GLuisF/KiCad/3D Models/6941xx301002.step

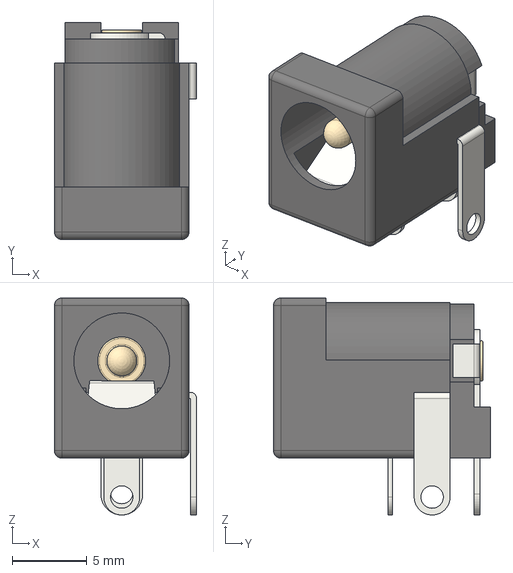
[picture p1: CAD file, 2022-11-30]
3D Models/6941xx301002.step
9.50 x 14.5 x 14.5 mm
