GLuisF/KiCad/3dmodels/TS02_66_70_BK_100_LCR.step

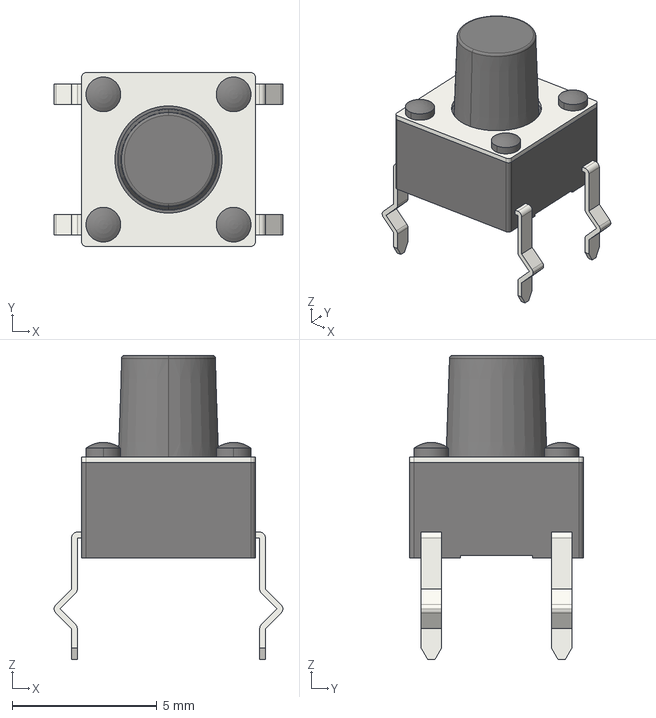
[picture p2: CAD file, 2025-11-11]
3dmodels/TS02_66_70_BK_100_LCR.step
7.90 x 6.00 x 10.5 mm
