GLuisF/KiCad/3dmodels/SS12F23.step

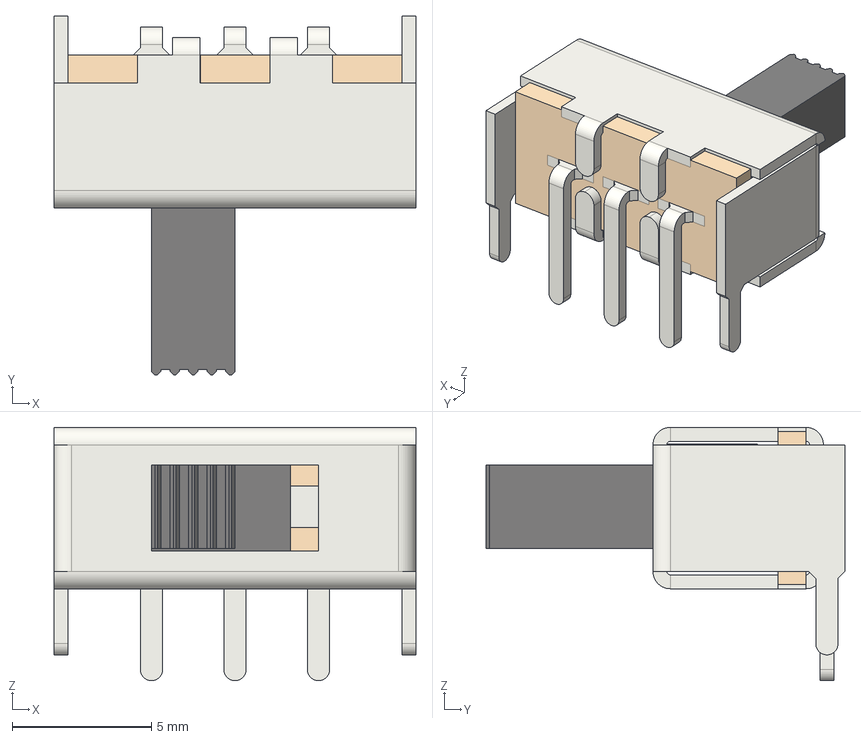
[picture p3: CAD file, 2025-09-01]
3dmodels/SS12F23.step
13.0 x 12.9 x 9.10 mm
