GLuisF/KiCad/3dmodels/SW_E-Switch_SS12F23_SPDT_Angled.step

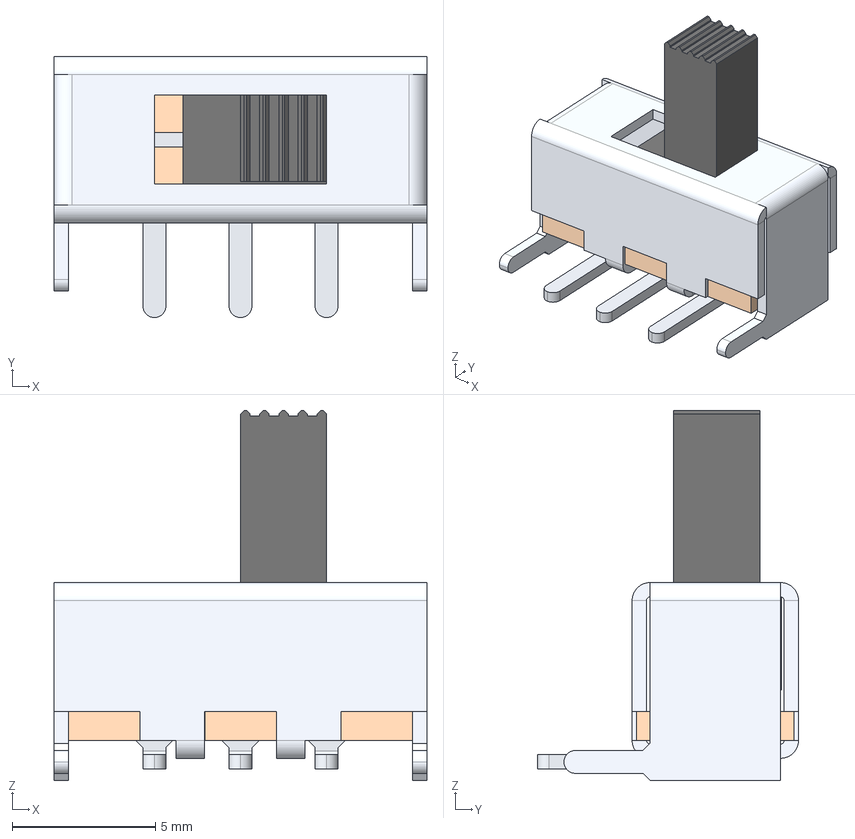
[picture p4: CAD file, 2025-09-01]
3dmodels/SW_E-Switch_SS12F23_SPDT_Angled.step
13.0 x 9.10 x 12.9 mm
SLIDE SWITCH SS12F23 CAPA_Valor predeterminado
SLIDE SWITCH SS12F23 PCB_Valor predeterminado
SLIDE SWITCH SS12F23 CENTRAL_Valor predeterminado
SLIDE SWITCH SS12F23 LATERAL_Valor predeterminado
SLIDE SWITCH SS12F23 LATERAL_Valor predeterminado001
SLIDE SWITCH SS12F23 ATUADOR_Valor predeterminado
SLIDE SWITCH SS12F23 Contato_Valor predeterminado
