GLuisF/KiCad/3dmodels/SW_Slide_SS12F23_SPDT_Angled.FCStd

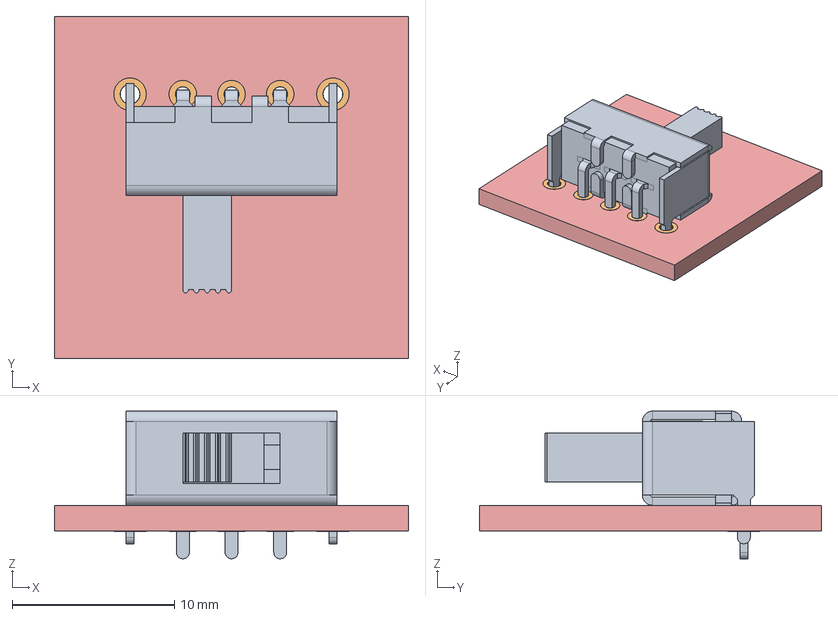
[picture p5: CAD file, 2025-09-01]
3dmodels/SW_Slide_SS12F23_SPDT_Angled.FCStd
21.8 x 21.1 x 9.10 mm
SS12F23
topPads
btmPads
TH-Drills
PCB
