GLuisF/KiCad/3dmodels/HW-106.step

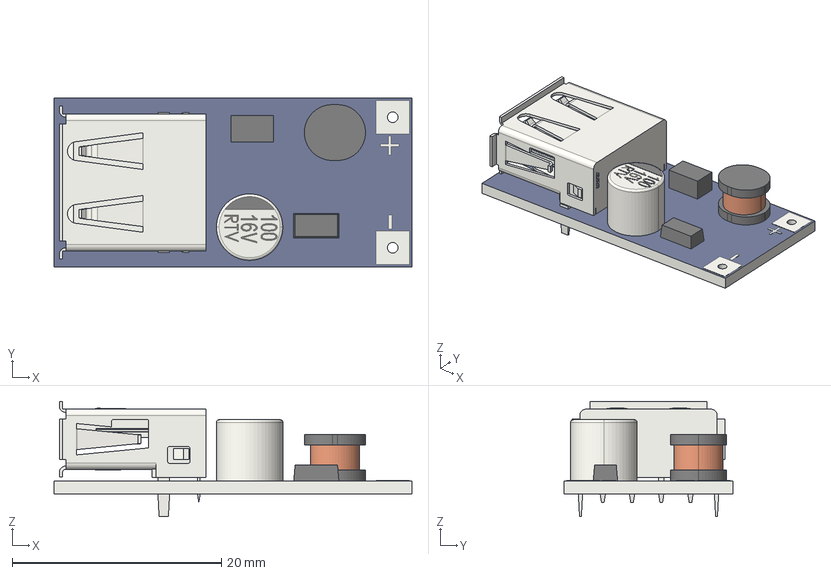
[picture p6: CAD file, 2025-08-31]
3dmodels/HW-106.step
34.2 x 16.2 x 11.0 mm
