GLuisF/KiCad/3dmodels/5621AH.step

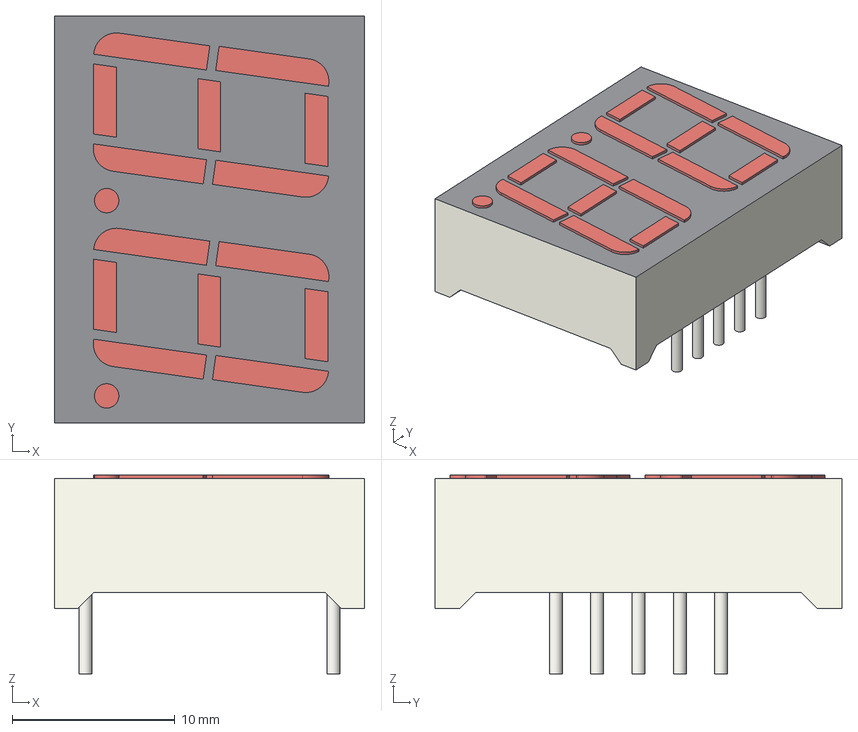
[picture p7: CAD file, 2025-08-25]
3dmodels/5621AH.step
19.1 x 25.0 x 12.2 mm
