GLuisF/KiCad/3dmodels/MQ-131-L.step

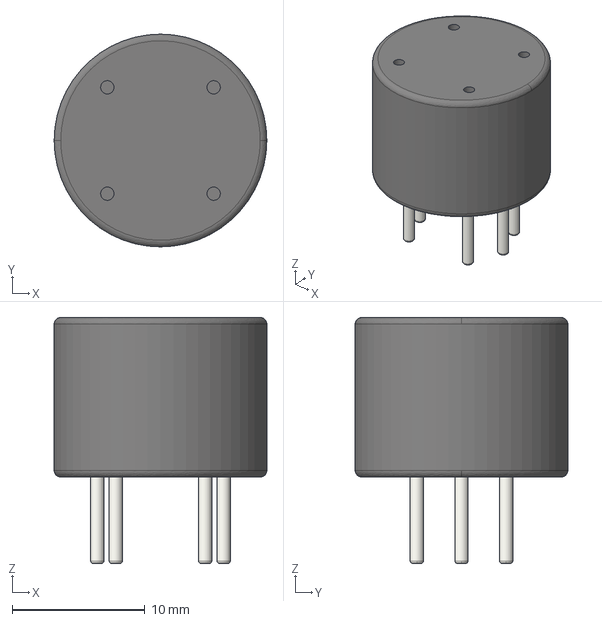
[picture p8: CAD file, 2025-06-23]
3dmodels/MQ-131-L.step
16.0 x 16.0 x 18.5 mm
