GLuisF/KiCad/3dmodels/FSM8JRT.step

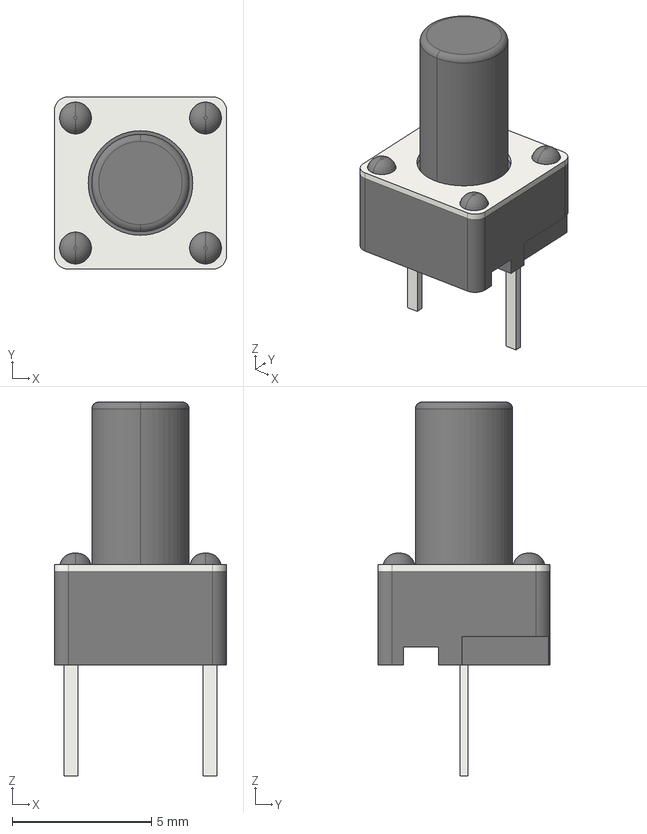
[picture p9: CAD file, 2025-05-14]
3dmodels/FSM8JRT.step
6.20 x 6.20 x 13.4 mm
