GLuisF/KiCad/3dmodels/TO-220-3_Vertical.step

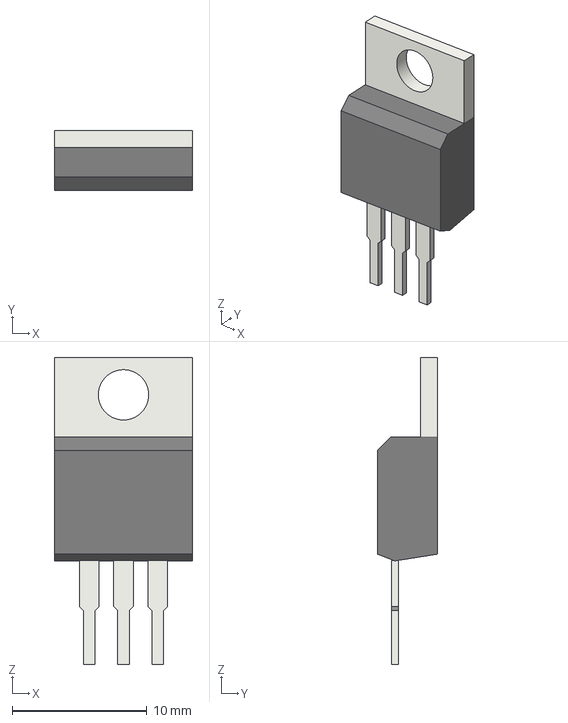
[picture p10: CAD file, 2025-05-14]
3dmodels/TO-220-3_Vertical.step
10.2 x 4.46 x 22.8 mm
