GLuisF/KiCad/3dmodels/3857 Adafruit Feather M4 Express.step

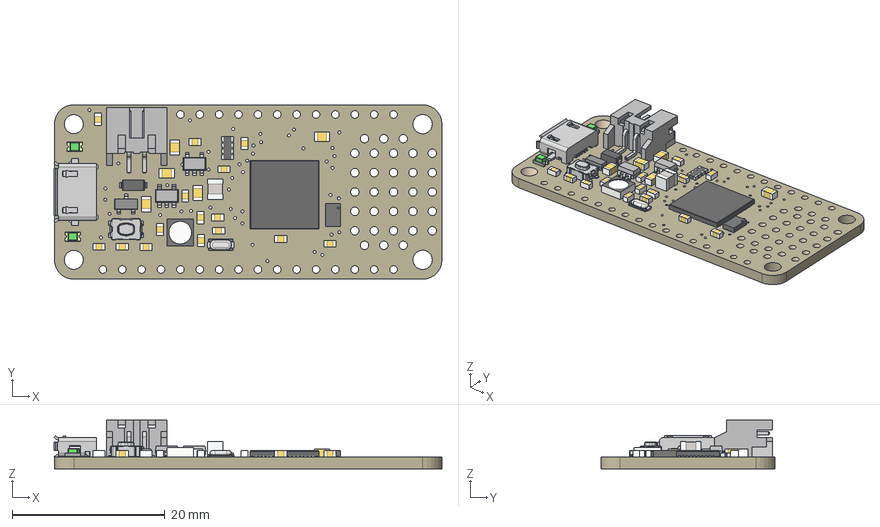
[picture p11: CAD file, 2025-02-12]
3dmodels/3857 Adafruit Feather M4 Express.step
50.9 x 22.9 x 6.37 mm
Board
10uF x 5
1uF x 15
ORANGE x 2
KMR2
microUSB
MCP73831T-2ACI/OT x 2
JSTPH
WS2812B3535
2MB Flash
MBR120
DMG341
100K
ATSAMD51J
10uH
