GLuisF/KiCad/3dmodels/PLCC2835_BLUE.stp

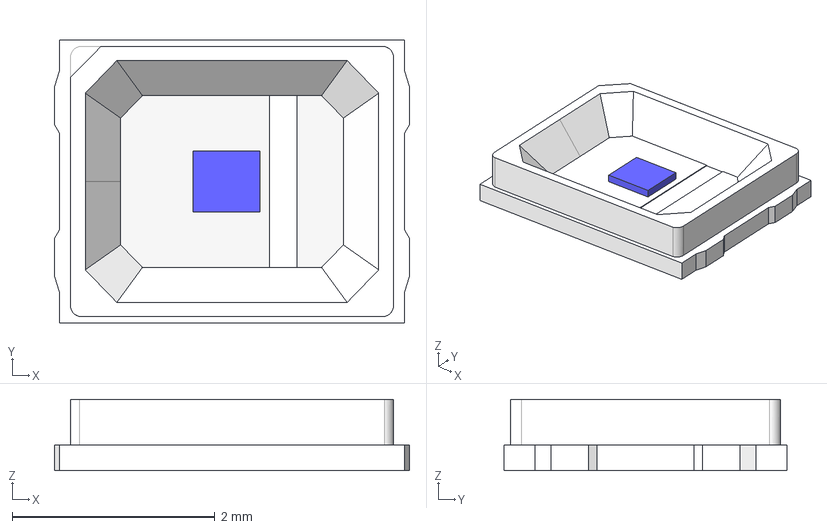
[picture p12: CAD file, 2025-02-12]
3dmodels/PLCC2835_BLUE.stp
3.50 x 2.79 x 0.7 mm
Document
