GLuisF/KiCad/3dmodels/SW_PUSH_E-Switch_FS57003P_3PDT.step

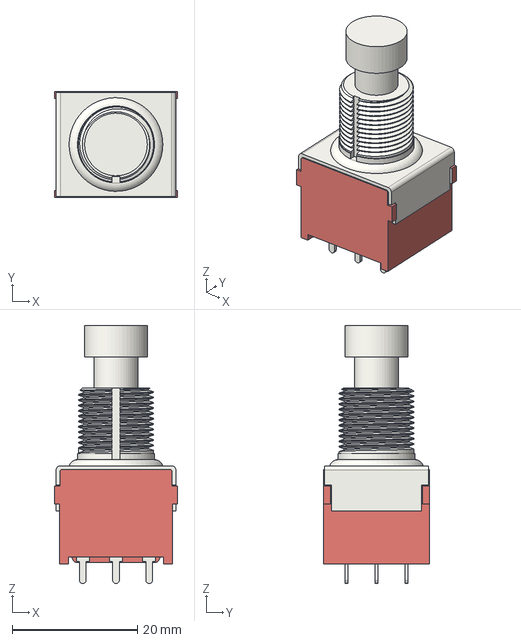
[picture p13: CAD file, 2024-08-29]
3dmodels/SW_PUSH_E-Switch_FS57003P_3PDT.step
19.7 x 17.0 x 41.2 mm
