GLuisF/KiCad/3dmodels/Jack_6.35mm_Amphenol_ACJS-MH_Horizontal.step

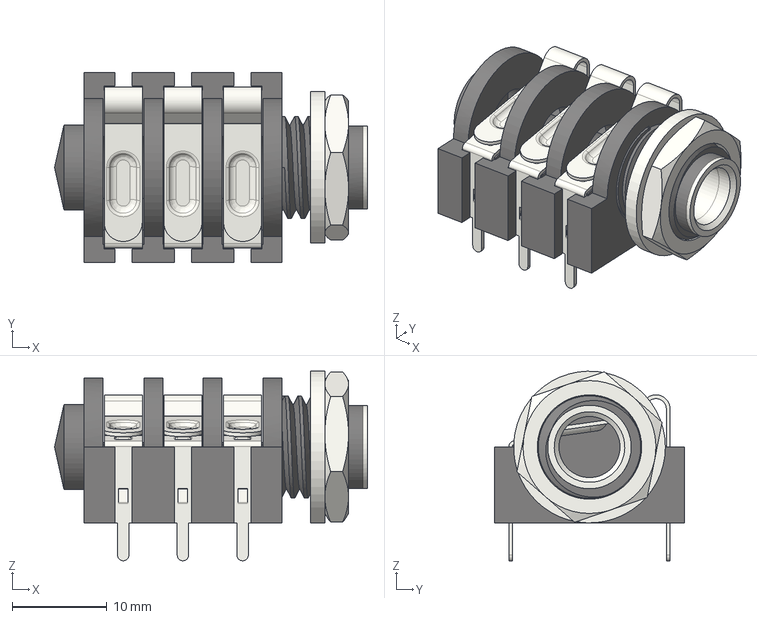
[picture p14: CAD file, 2024-08-29]
3dmodels/Jack_6.35mm_Amphenol_ACJS-MH_Horizontal.step
33.0 x 20.0 x 20.0 mm
