GLuisF/KiCad/3dmodels/CP_Radial_D5.0mm_H11.0mm_P2.00mm.step

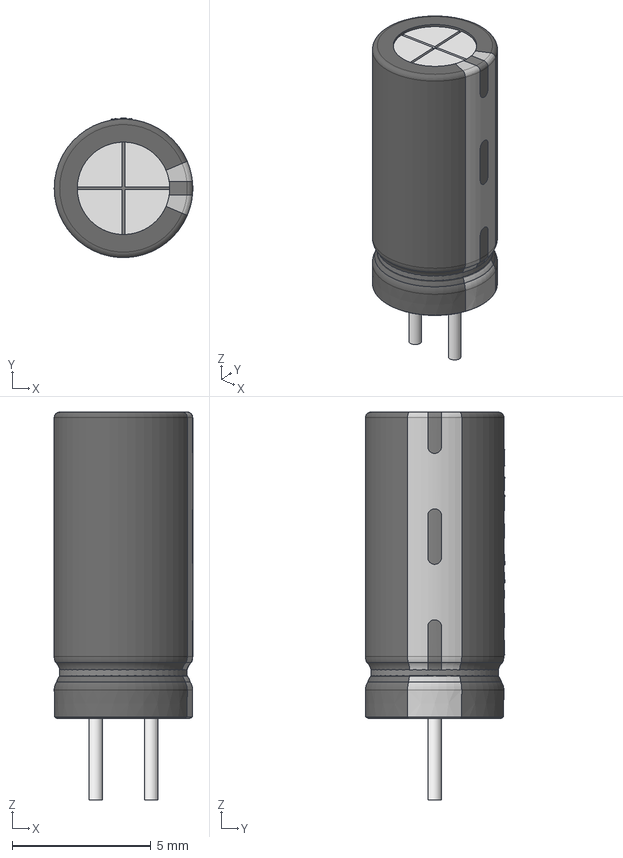
[picture p15: CAD file, 2024-07-31]
3dmodels/CP_Radial_D5.0mm_H11.0mm_P2.00mm.step
5.00 x 5.02 x 14.0 mm
