GLuisF/KiCad/3dmodels/COM-10597.step

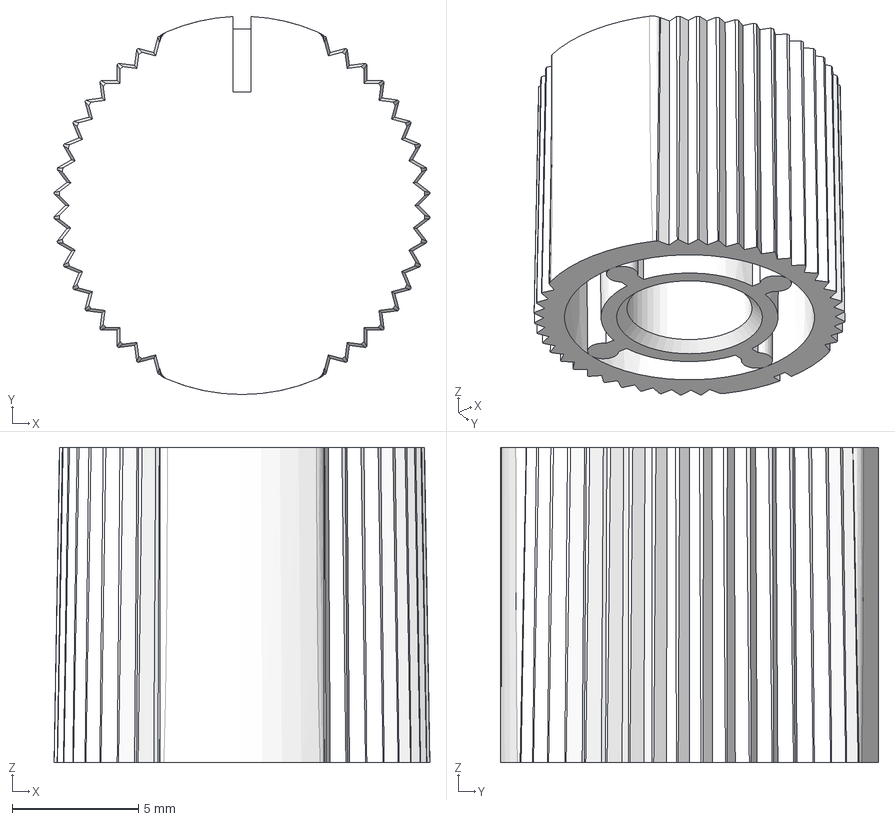
[picture p16: CAD file, 2024-07-03]
3dmodels/COM-10597.step
14.9 x 15.0 x 12.5 mm
