GLuisF/KiCad/3dmodels/TerminalBlock_bornier-2_P5.08mm.step

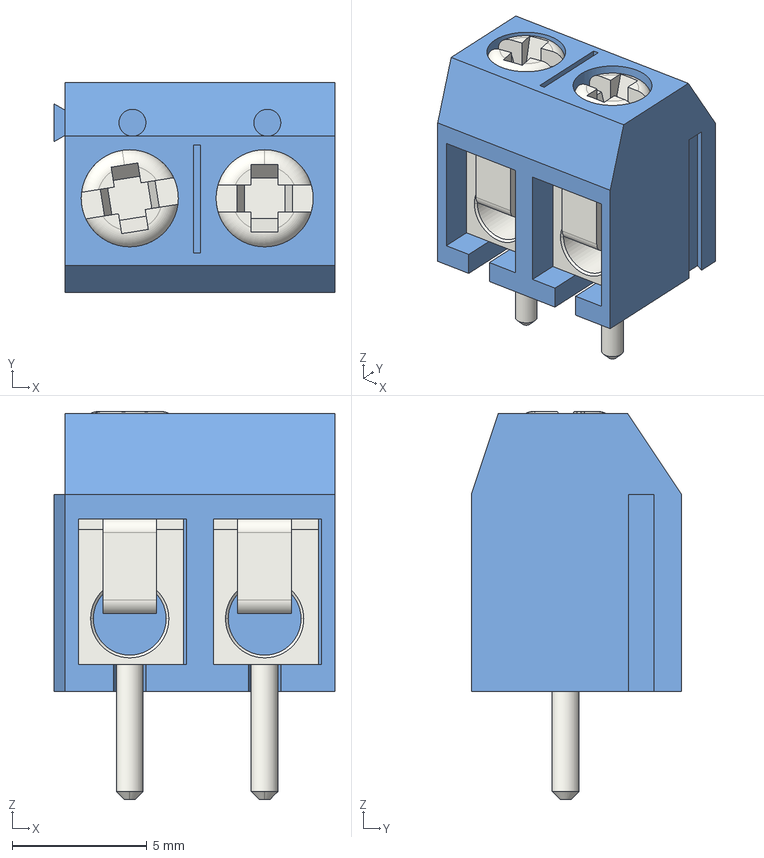
[picture p17: CAD file, 2023-12-06]
3dmodels/TerminalBlock_bornier-2_P5.08mm.step
10.4 x 7.80 x 14.4 mm
