GLuisF/KiCad/3dmodels/3386F.step

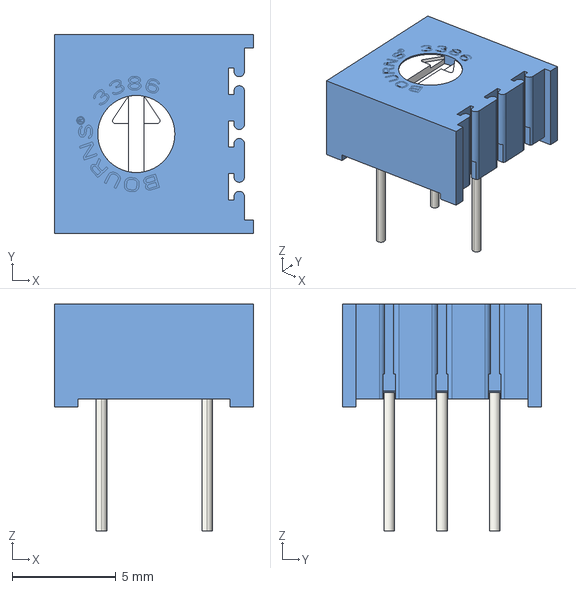
[picture p18: CAD file, 2023-12-06]
3dmodels/3386F.step
9.58 x 9.58 x 10.9 mm
