GLuisF/KiCad/3dmodels/TO-247-3_Horizontal_TabUp.step

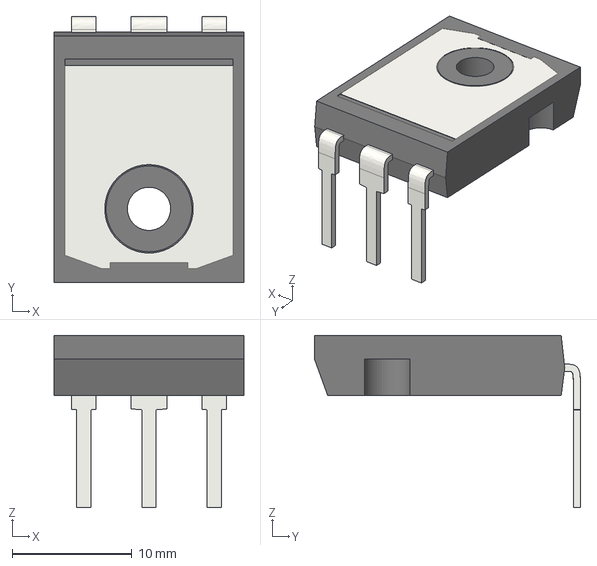
[picture p19: CAD file, 2023-12-06]
3dmodels/TO-247-3_Horizontal_TabUp.step
15.9 x 22.3 x 14.4 mm
