GLuisF/KiCad/3dmodels/TerminalBlock_bornier-3_P5.08mm.step

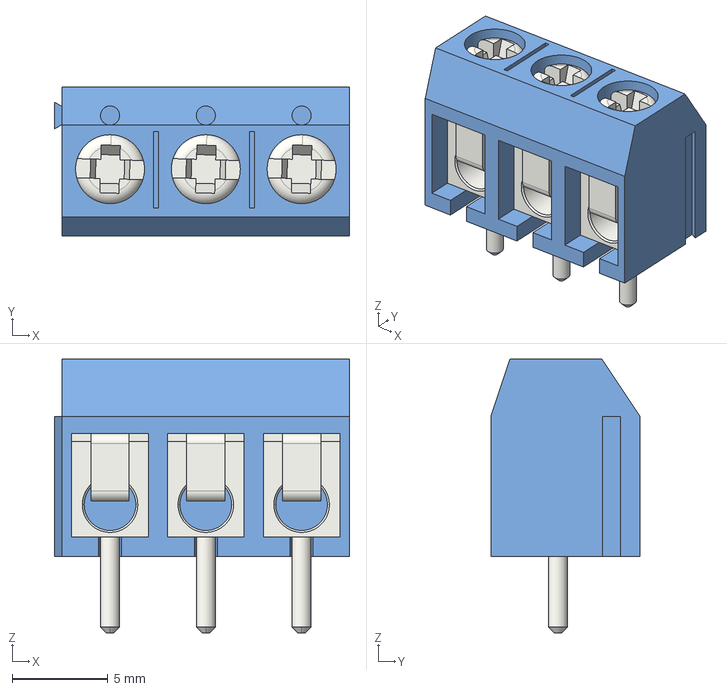
[picture p20: CAD file, 2023-12-06]
3dmodels/TerminalBlock_bornier-3_P5.08mm.step
15.4 x 7.80 x 14.3 mm
