GLuisF/KiCad/3dmodels/Potentiometer_Bourns_3386F_Vertical.step

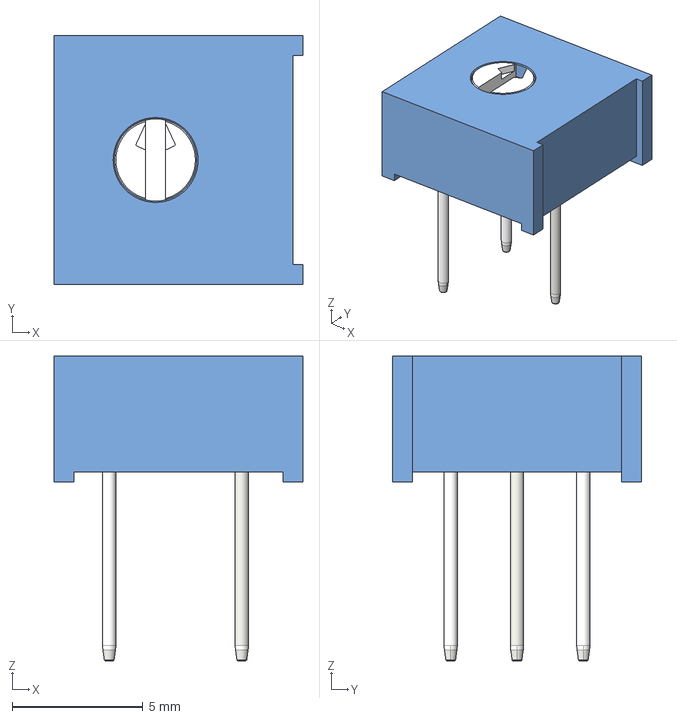
[picture p21: CAD file, 2023-12-06]
3dmodels/Potentiometer_Bourns_3386F_Vertical.step
9.52 x 9.53 x 11.7 mm
