GLuisF/KiCad/3dmodels/RJ12_Amphenol_54601-x06_Horizontal.step

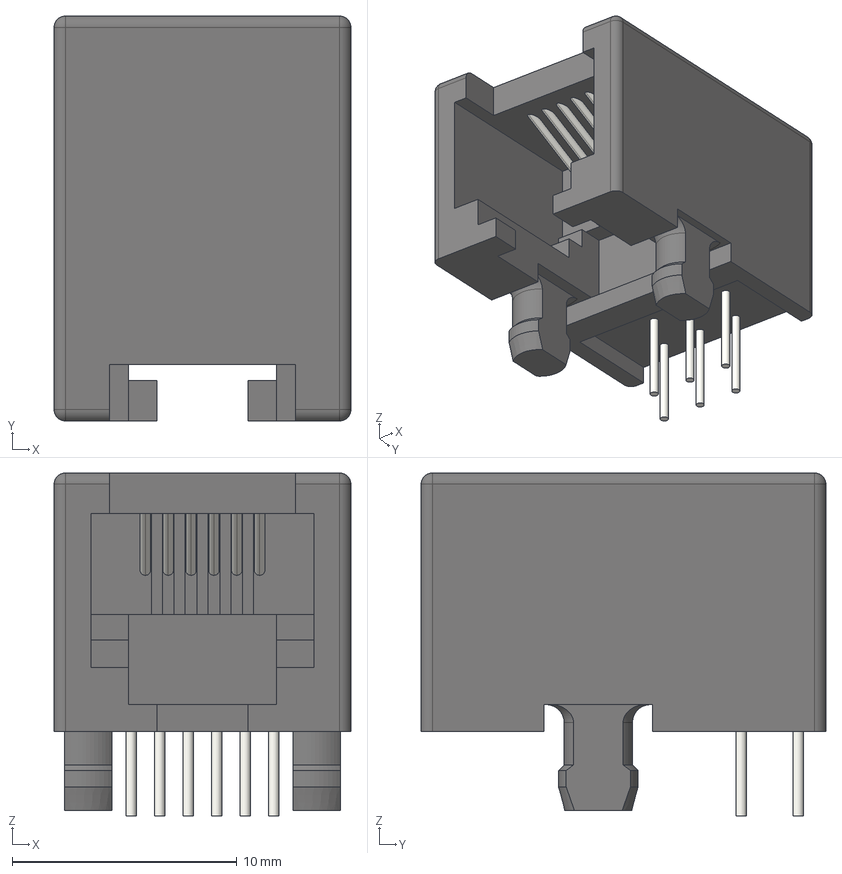
[picture p22: CAD file, 2023-10-30]
3dmodels/RJ12_Amphenol_54601-x06_Horizontal.step
13.2 x 18.0 x 15.2 mm
