GLuisF/KiCad/3dmodels/PEC12R-4222F-S0024.step

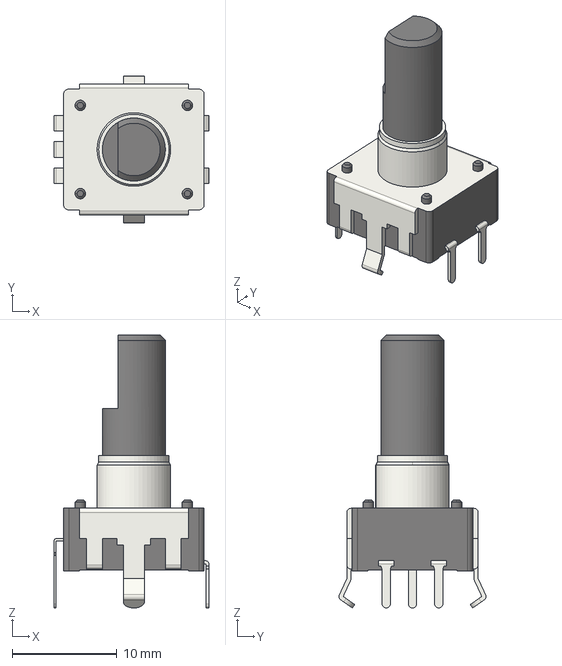
[picture p23: CAD file, 2023-07-28]
3dmodels/PEC12R-4222F-S0024.step
14.7 x 14.0 x 26.0 mm
