GLuisF/KiCad/3dmodels/SOIC-14_to_DIP-14_Adapter.step

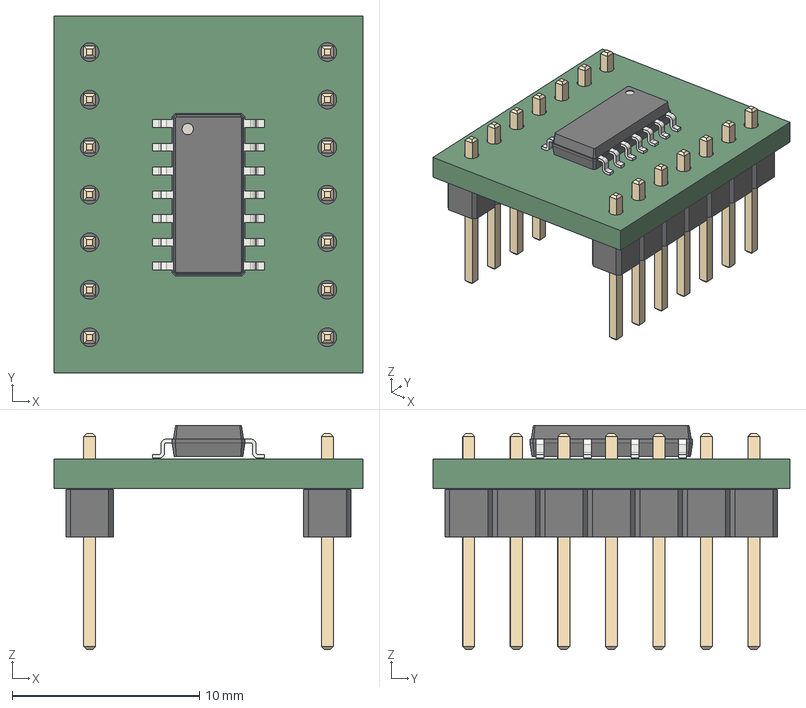
[picture p24: CAD file, 2023-06-08]
3dmodels/SOIC-14_to_DIP-14_Adapter.step
16.5 x 19.1 x 12.0 mm
