GLuisF/KiCad/3dmodels/Interruptor Liga_Desliga.STEP

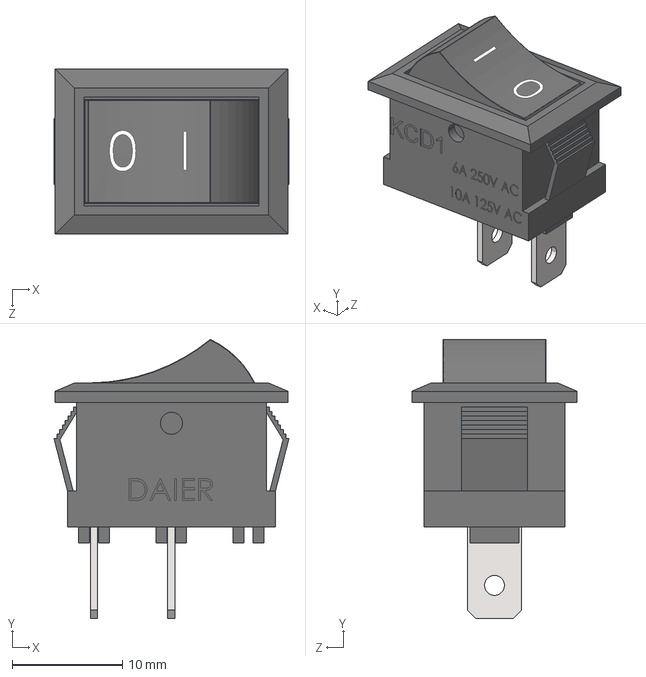
[picture p25: CAD file, 2022-12-01]
3dmodels/Interruptor Liga_Desliga.STEP
21.3 x 25.3 x 15.0 mm
