GLuisF/KiCad/3dmodels/PEL12T-4225S-S1024.step

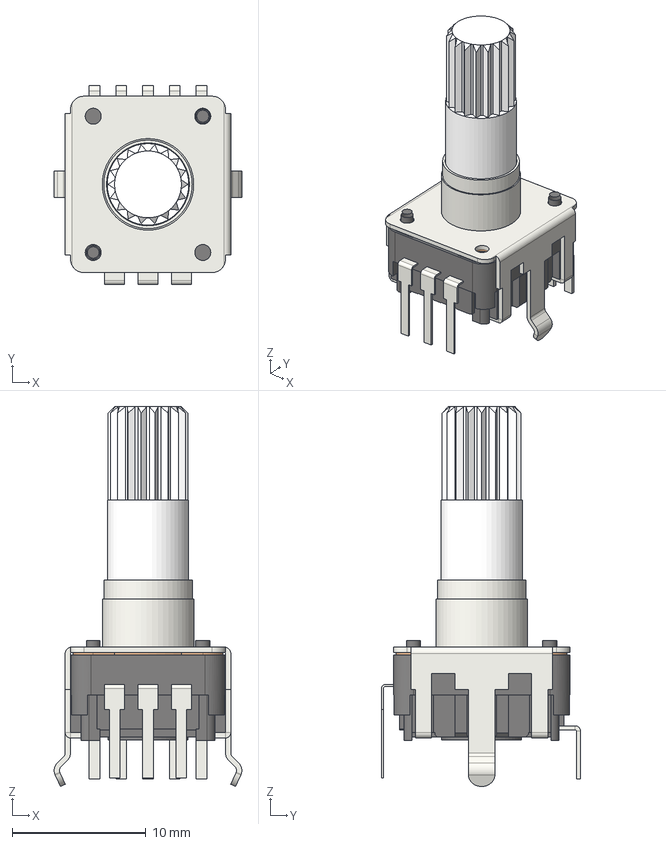
[picture p26: CAD file, 2022-12-01]
3dmodels/PEL12T-4225S-S1024.step
14.1 x 14.9 x 28.4 mm
