GLuisF/KiCad/3dmodels/panel_on-off_spdt.step

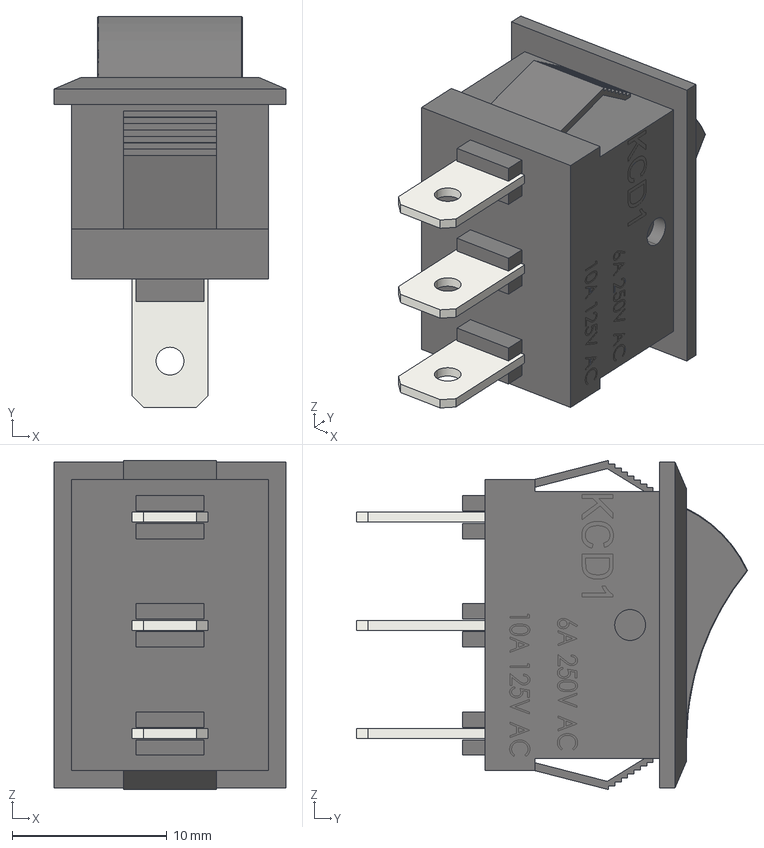
[picture p27: CAD file, 2022-12-01]
3dmodels/panel_on-off_spdt.step
15.0 x 25.3 x 21.3 mm
