GLuisF/KiCad/3dmodels/WE-TPC_3816.step

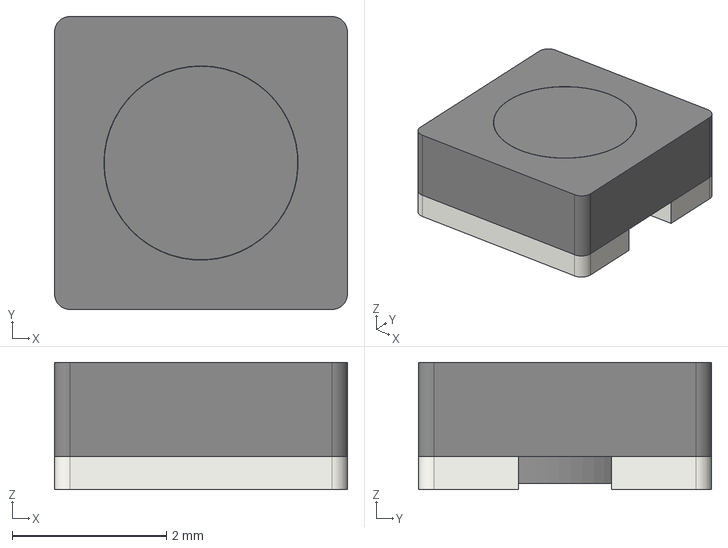
[picture p28: CAD file, 2022-11-30]
3dmodels/WE-TPC_3816.step
3.80 x 3.80 x 1.65 mm
