GLuisF/KiCad/3dmodels/WE-TPC_5828.stp

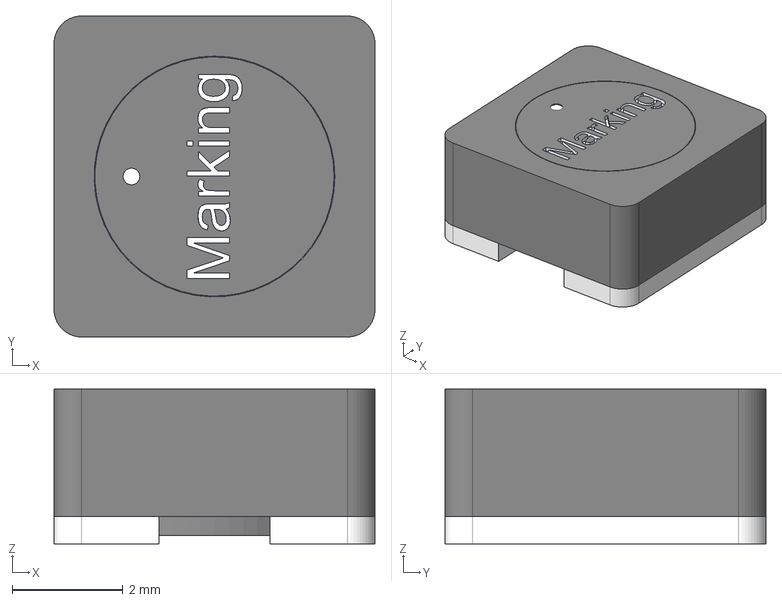
[picture p29: CAD file, 2022-11-30]
3dmodels/WE-TPC_5828.stp
5.80 x 5.80 x 2.80 mm
