GLuisF/KiCad/3dmodels/LED_D3.0mm_Green.step

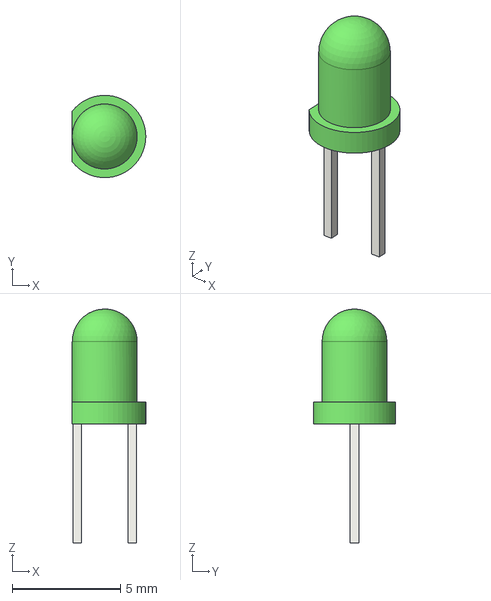
[picture p30: CAD file, 2022-04-01]
3dmodels/LED_D3.0mm_Green.step
3.40 x 3.80 x 10.8 mm
