GLuisF/KiCad/3dmodels/LED_D3.0mm_Green.FCStd.stp

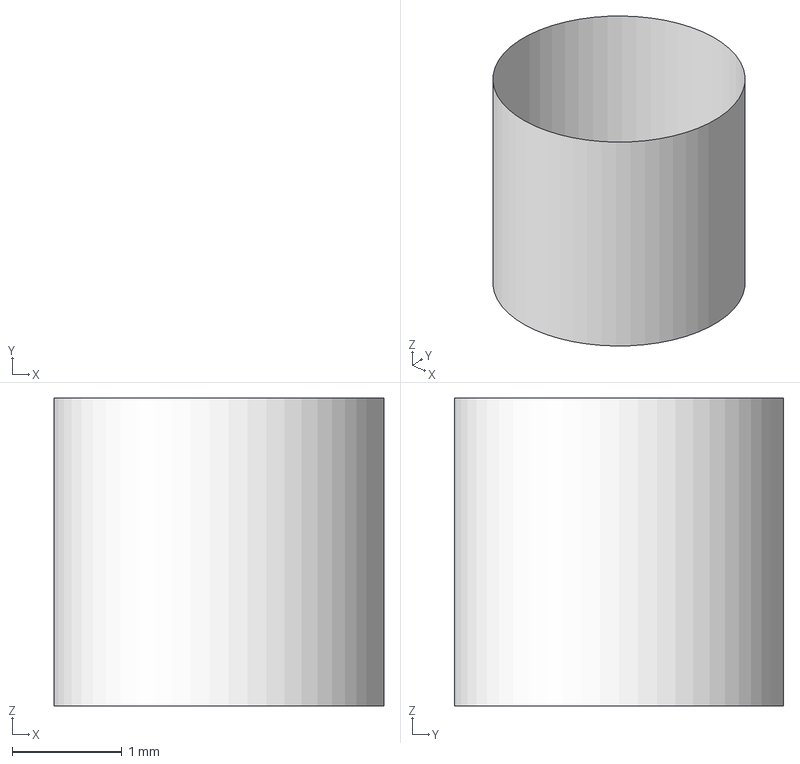
[picture p31: CAD file, 2022-04-01]
3dmodels/LED_D3.0mm_Green.FCStd.stp
3.00 x 2.99 x 2.80 mm
