GLuisF/KiCad/3dmodels/FT234XD_Stencil.FCStd

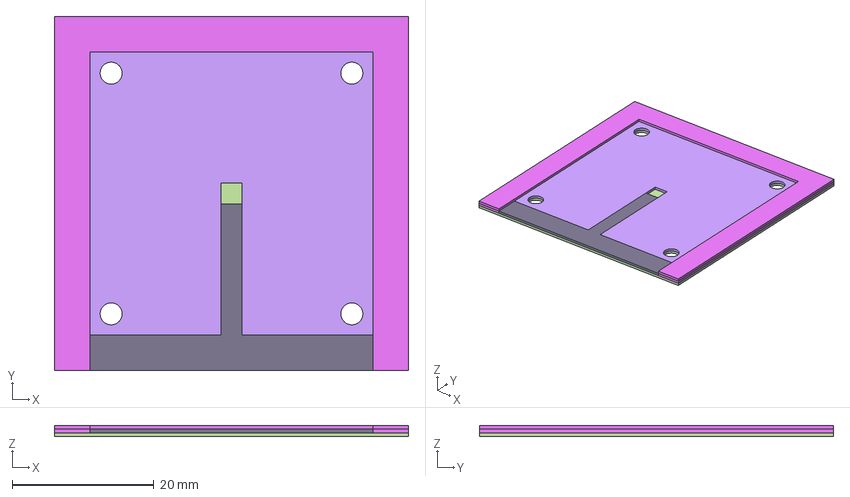
[picture p32: CAD file, 2022-01-10]
3dmodels/FT234XD_Stencil.FCStd
50.0 x 50.0 x 1.50 mm
Base Chip
Suporte Chip
Suporte Stencil 1
Fixador Chip
Suporte Stencil 2
