GLuisF/KiCad/3dmodels/STM32F103T8U6_Stencil.FCStd

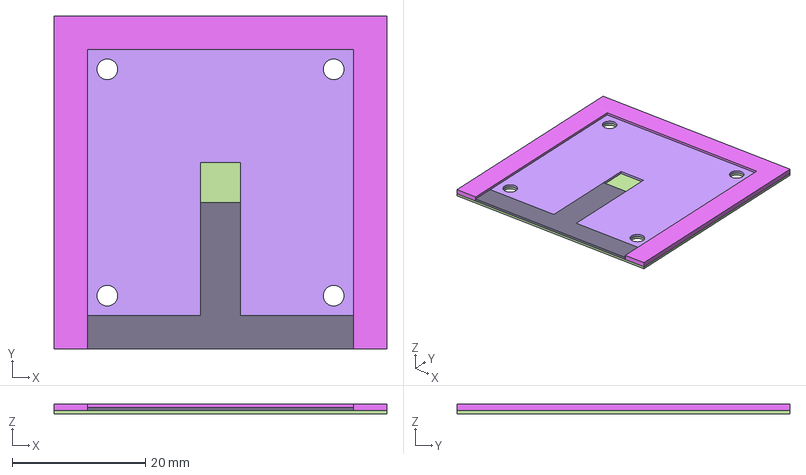
[picture p33: CAD file, 2022-01-10]
3dmodels/STM32F103T8U6_Stencil.FCStd
50.0 x 50.0 x 1.50 mm
Base Chip
Suporte Chip
Suporte Stencil
Fixador Chip
