GLuisF/KiCad/3dmodels/STM32F103T8U6.step

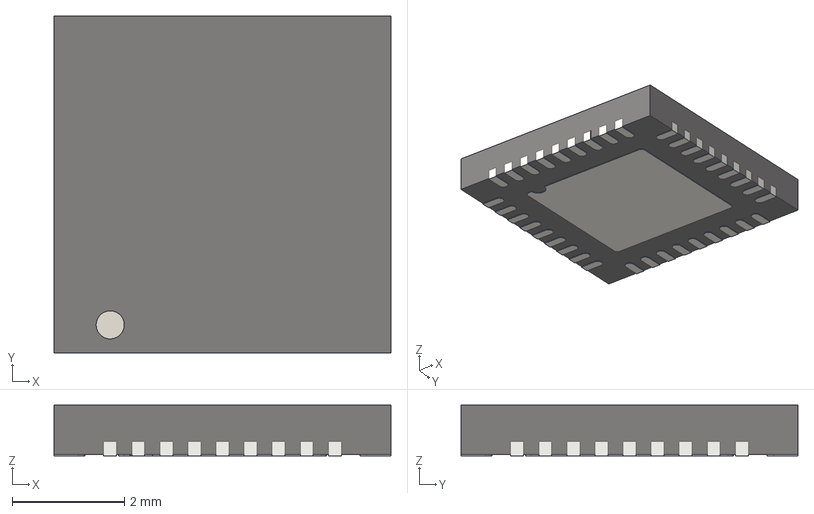
[picture p34: CAD file, 2021-09-27]
3dmodels/STM32F103T8U6.step
6.00 x 6.00 x 0.9 mm
