GLuisF/KiCad/3dmodels/2410.step

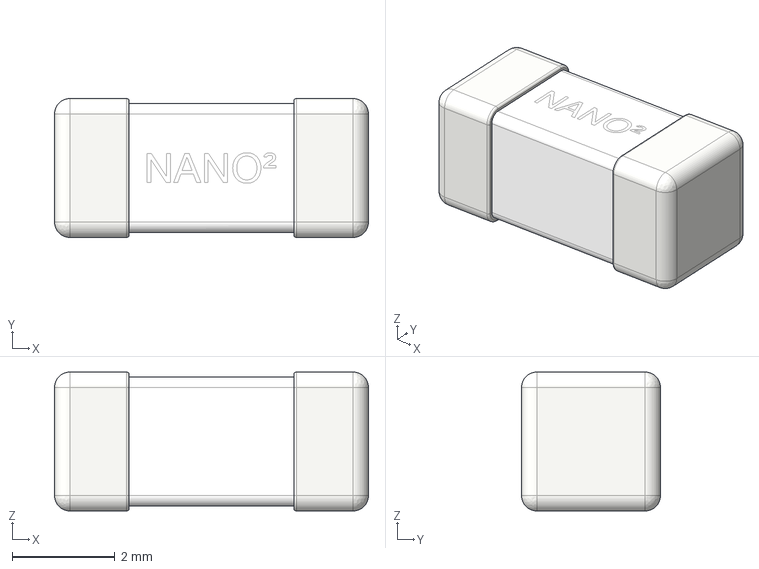
[picture p35: CAD file, 2021-09-27]
3dmodels/2410.step
6.10 x 2.70 x 2.70 mm
