GLuisF/KiCad/3dmodels/C_TANT_1206_3216Metric.step

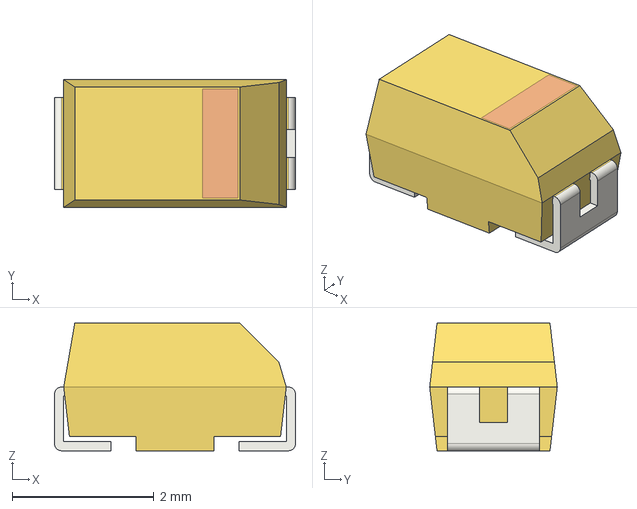
[picture p36: CAD file, 2021-09-27]
3dmodels/C_TANT_1206_3216Metric.step
3.40 x 1.80 x 1.80 mm
