GLuisF/KiCad/3dmodels/SJP.step

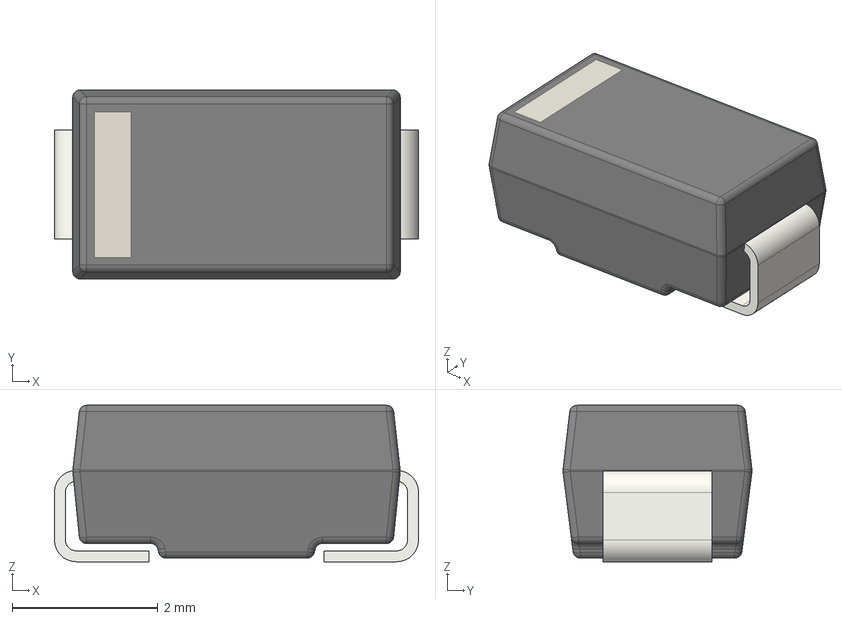
[picture p37: CAD file, 2021-09-08]
3dmodels/SJP.step
5.00 x 2.60 x 2.15 mm
