GLuisF/KiCad/3dmodels/3225.step

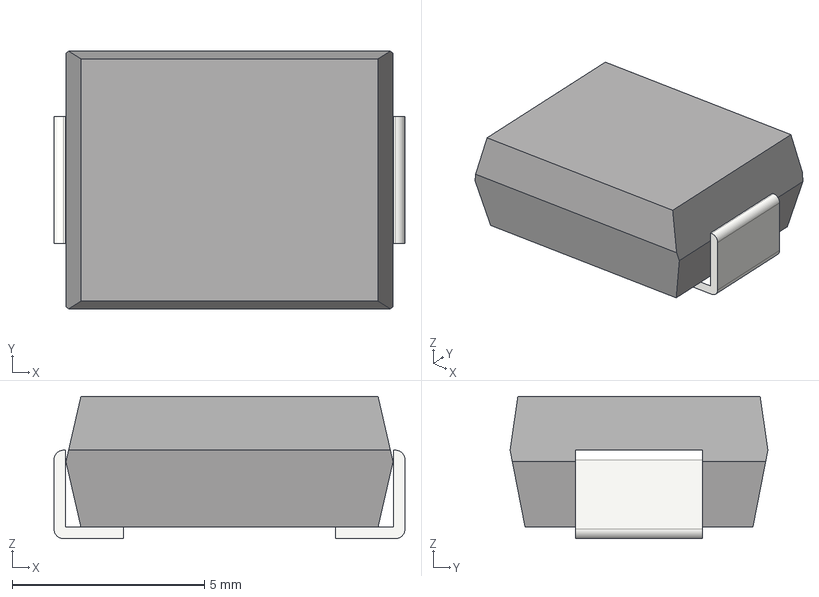
[picture p38: CAD file, 2021-09-08]
3dmodels/3225.step
9.12 x 6.70 x 3.70 mm
