GLuisF/KiCad/3dmodels/4032.step

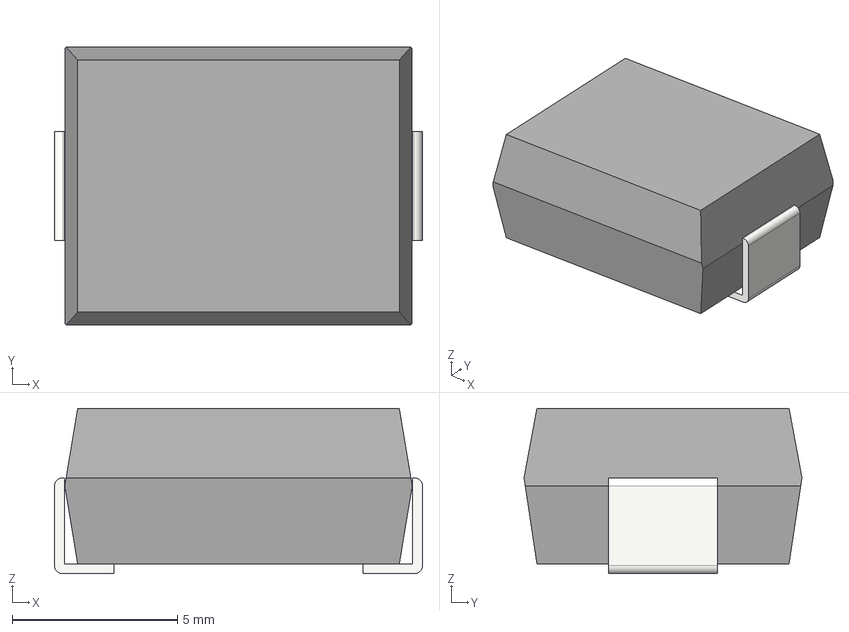
[picture p39: CAD file, 2021-09-08]
3dmodels/4032.step
11.1 x 8.40 x 5.00 mm
