GLuisF/KiCad/3dmodels/PDB181-K415K-103B001.step

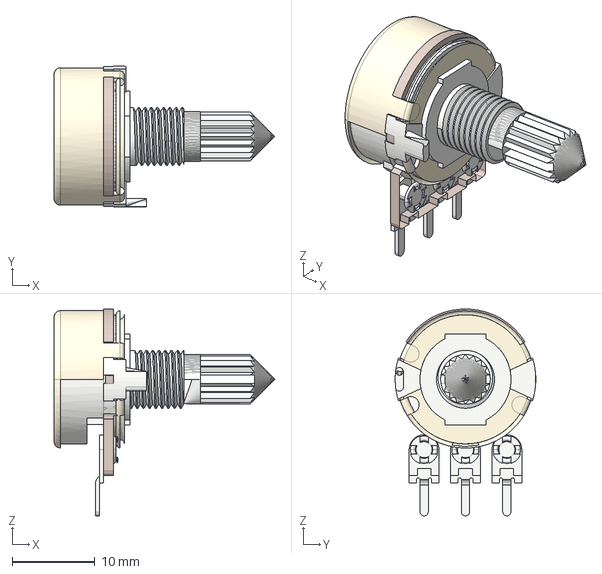
[picture p40: CAD file, 2021-07-23]
3dmodels/PDB181-K415K-103B001.step
26.7 x 17.0 x 25.0 mm
