GLuisF/KiCad/3dmodels/PTD901_XX15K_XXXX.step

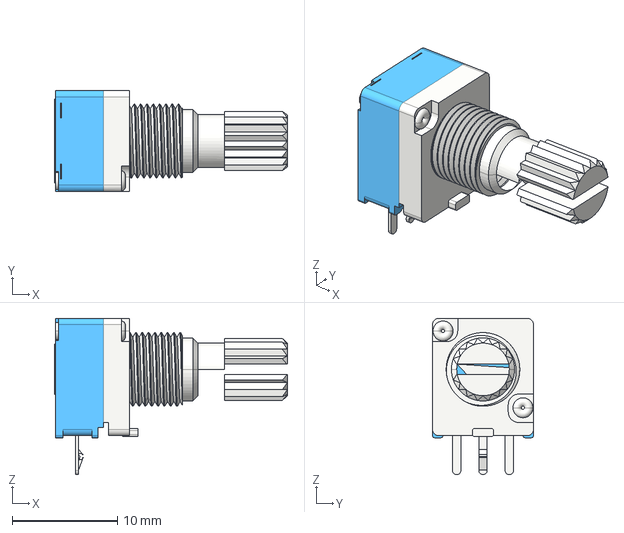
[picture p41: CAD file, 2021-07-16]
3dmodels/PTD901_XX15K_XXXX.step
22.2 x 9.60 x 14.9 mm
