GLuisF/KiCad/3dmodels/PTD902_XX15K_XXXX.step

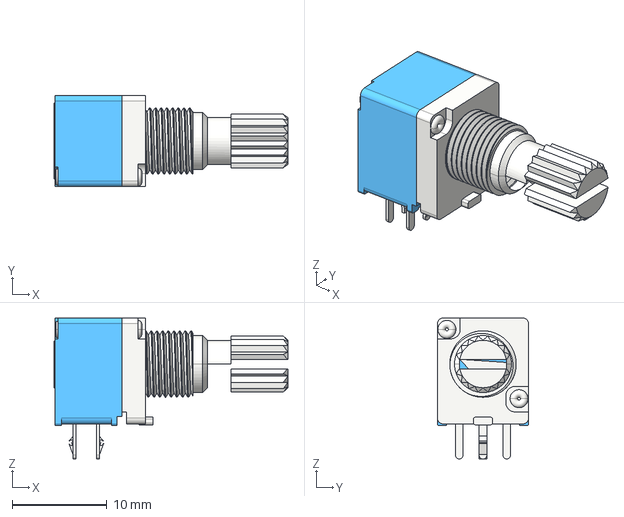
[picture p42: CAD file, 2021-07-16]
3dmodels/PTD902_XX15K_XXXX.step
24.6 x 9.60 x 14.9 mm
