GLuisF/KiCad/3dmodels/TPA511GLFS.step

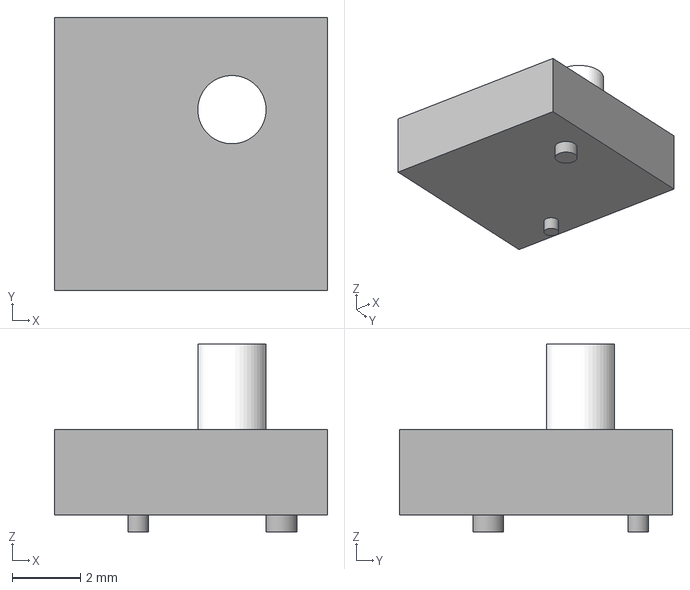
[picture p43: CAD file, 2021-06-14]
3dmodels/TPA511GLFS.step
8.00 x 8.00 x 5.50 mm
