GLuisF/KiCad/3dmodels/SOP-24.step

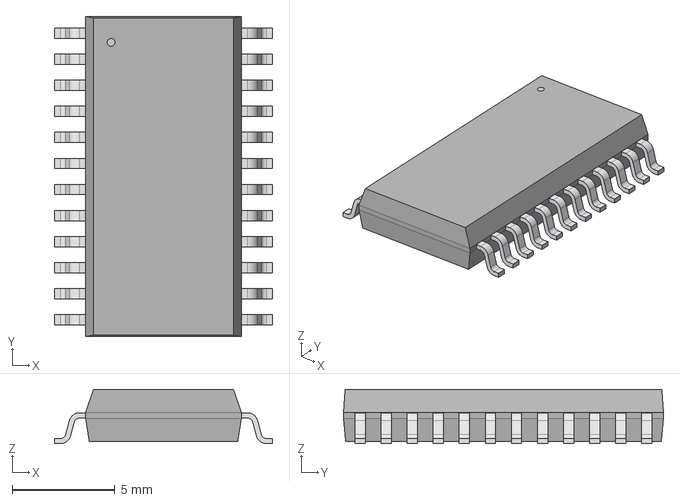
[picture p44: CAD file, 2021-06-13]
3dmodels/SOP-24.step
10.6 x 15.6 x 2.64 mm
