GLuisF/KiCad/3dmodels/54-00023.step

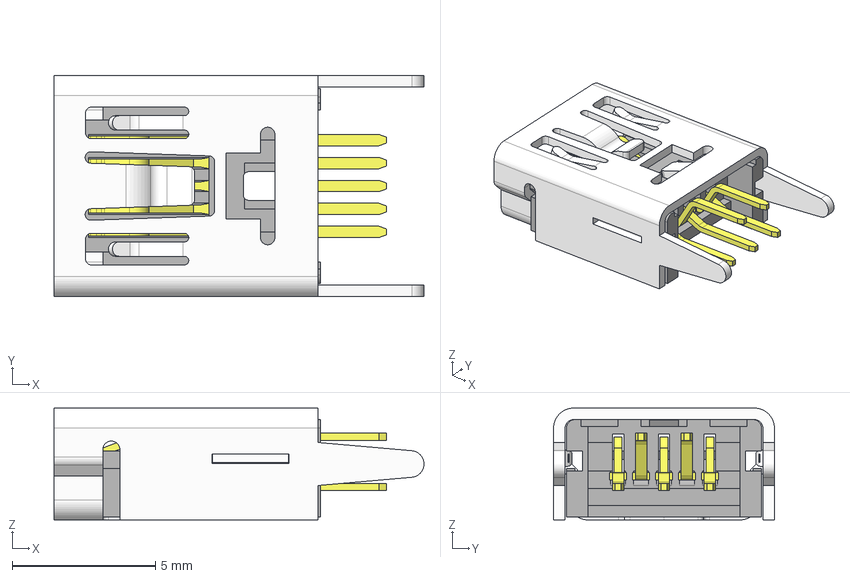
[picture p45: CAD file, 2021-06-13]
3dmodels/54-00023.step
12.9 x 7.70 x 3.90 mm
54-00023_shell
54-00023_insulator
54-00023_pin4
54-00023_pin2
54-00023_pin3
54-00023_pin1
54-00023_pin5
