GLuisF/KiCad/(list of files, cad)

Other CAD files:
3dmodels/6941xx301004.step
3dmodels/0679H2000-01.step
3dmodels/3386F.FCStd
3dmodels/5621AH.FCStd
3dmodels/5621AH.stp
3dmodels/691101710002.FCStd
3dmodels/691101710002.step
3dmodels/691101710002.stp
3dmodels/694106301002.FCStd
3dmodels/694106301002.step
3dmodels/694106301002.stp
3dmodels/C_TANT_1206_3216Metric.FCStd
3dmodels/FSM8JRT.FCStd
3dmodels/HW-106.FCStd
3dmodels/Jack_6.35mm_Amphenol_ACJS-MH_Horizontal.FCStd
3dmodels/LED_D3.0mm_Green.FCStd
3dmodels/MQ-131-L.FCStd
3dmodels/PEC12R-4222F-S0024.FCStd
3dmodels/PEL12T-4225S-S1024.FCStd
3dmodels/Potentiometer_Bourns_3386F_Vertical.FCStd
3dmodels/RJ12_Amphenol_54601-x06_Horizontal.FCStd
3dmodels/SJP.FCStd
3dmodels/SOIC-14_to_DIP-14_Adapter.FCStd
3dmodels/SOIC-14_to_DIP-14_Adapter_old.step
3dmodels/STM32F103T8U6.FCStd
3dmodels/SW_PUSH_E-Switch_FS57003P_3PDT.FCStd
3dmodels/TO-220-3_Vertical.FCStd
3dmodels/TO-247-3_Horizontal_TabUp.FCStd
3dmodels/TS02_66_70_BK_100_LCR.FCStd
3dmodels/TerminalBlock_bornier-2_P5.08mm.FCStd
3dmodels/TerminalBlock_bornier-3_P5.08mm.FCStd
3dmodels/WE-TPC_3816.FCStd
3dmodels/WE-TPC_3816.stp
3dmodels/panel_on-off_spdt.FCStd
