GLuisF/KiCad/(commit log)

2021-06-24 SJP footprint
    [SJP.FCStd]
2021-06-25 Update SJP
    [SJP.FCStd, SJP.step]
2021-07-16 New components
    [3386F.step, PTD901_XX15K_XXXX.step, PTD902_XX15K_XXXX.step]
2021-07-23 New footprint
    [PDB181-K415K-103B001.step]
2021-09-08 New cmps
    [3225.step, 4032.step, SJP.FCStd, SJP.step, STM32F103T8U6.FCStd, STM32F103T8U6.step, STM32F103T8U6_Stencil.FCStd]
2022-07-20 add jack dc 3d model
    [694106301002.FCStd, 694106301002.stp, 6941xx301002.step]
2022-11-28 Added SOIC-14 to DIP_14 adapter
    [SOIC-14_to_DIP-14_Adapter.FCStd, SOIC-14_to_DIP-14_Adapter.step]
2022-11-30 Added WE-TPC-3816 3D model Inductor
    [WE-TPC_3816.FCStd, WE-TPC_3816.step, WE-TPC_3816.stp, WE-TPC_5828.stp]
2023-07-04 Add 3D to Pot 3386
    [3386F.step]
2023-10-30 3d model for RJ12
    [RJ12_Amphenol_54601-x06_Horizontal.FCStd, RJ12_Amphenol_54601-x06_Horizontal.step]
2024-08-29 update kicad components
    [6941xx301002.FCStd, 6941xx301008_sp.step, Jack_6.35mm_Amphenol_ACJS-MH_Horizontal.FCStd, Jack_6.35mm_Amphenol_ACJS-MH_Horizontal.step, SW_PUSH_E-Switch_FS57003P_3PDT.FCStd, SW_PUSH_E-Switch_FS57003P_3PDT.step]
2024-09-02 Create Caixa-1590B Cortes.kicad_mod
2024-09-02 Update Caixa-1590B Cortes.kicad_mod
2024-09-06 Added Tactile Switch
    [FSM8JRT.FCStd, FSM8JRT.step]
2025-02-25 Remove old lib folders
    [2410.step, 3225.step, 3386F.step, 4032.step, 54-00023.step, 694106301002.FCStd, 694106301002.step, 694106301002.stp]
2025-06-23 Added MQ-131-L
    [MQ-131-L.FCStd, MQ-131-L.step]
2025-08-08 Add CaixaContadorTruco symbol to library
    Introduced a new symbol 'CaixaContadorTruco' for a 3D printed Truco counter box, including properties for reference, description, and price. This addition expands the symbol library for mechanical components.
2025-08-24 Add VA-5621AH symbol and footprint
    Introduced the VA-5621AH double 7-segment LED display symbol to GLuisF.kicad_sym and added its footprint to GLuisF.pretty. Includes properties, pinout, and graphical representation for use in KiCad projects.
2025-08-25 Add 5621AH 3D models, footprint, and update symbol
    Added multiple 3D model files for the 5621AH part in various formats (STEP, FreeCAD, WRL), a new KiCad footprint, and updated the GLuisF symbol library. Removed the obsolete VA-5621AH footprint to reflect the new part addition.
    [5621AH.FCStd, 5621AH.step, 5621AH.stp]
2025-08-31 Added USB C TP4056 Battery Charger and HW-106 Step
    [HW-106.FCStd, HW-106.step]
2025-10-01 Update silkscreen labels on HW-106 and TP4056 footprints
    Added user text labels for IN+/IN-/OUT+/OUT- on the HW-106 footprint (B.SilkS layer). Moved and mirrored user text labels on the TP4056_BatteryCharger_USB-C footprint from F.SilkS to B.SilkS and adjusted justification for improved clarity on the board's bottom silkscreen.
2025-11-11 Add TS02_66_70_BK_100_LCR 3D models and footprint
    Added 3D model files (.FCStd, .step, .wrl, .FCBak) and a KiCad footprint for the TS02_66_70_BK_100_LCR component. This enables accurate mechanical and PCB representation for this part in the project.
    [TS02_66_70_BK_100_LCR.FCStd, TS02_66_70_BK_100_LCR.step]
2026-07-29 Split GLuisF symbol lib into per-symbol files
    Remove the large monolithic symbols/GLuisF.kicad_sym and replace it with a directory-style library (symbols/GLuisF.kicad_symdir/) containing individual .kicad_sym files for each component (5621AH, ACSA56-41SRWA-F01, AT89C1051-24PC, ATmega328-P, USB4155-03-C, TP4056..., etc.). This splits the symbol library into per-symbol files for easier maintenance and better compatibility with KiCad's symbol directory format.
